J-Afzal/First-Year-Project/README.md

# Lab 1
This lab consisted of building the car from scratch, including soldering all the components needed for all PCBs, and connecting the Arduino to the four motors. Then the Arduino was first coded to move the car in a straight line for a certain distance (as shown in the gif below and to the left), then was coded to move the car in a square route of a certain size (as shown in the gif below and to the right) and whose code is shown in `Lab 1/code/Course1.ino`, and finally in a zig-zag shape whose code is shown in `Lab 1/code/Course2.ino`.

<p align="center">
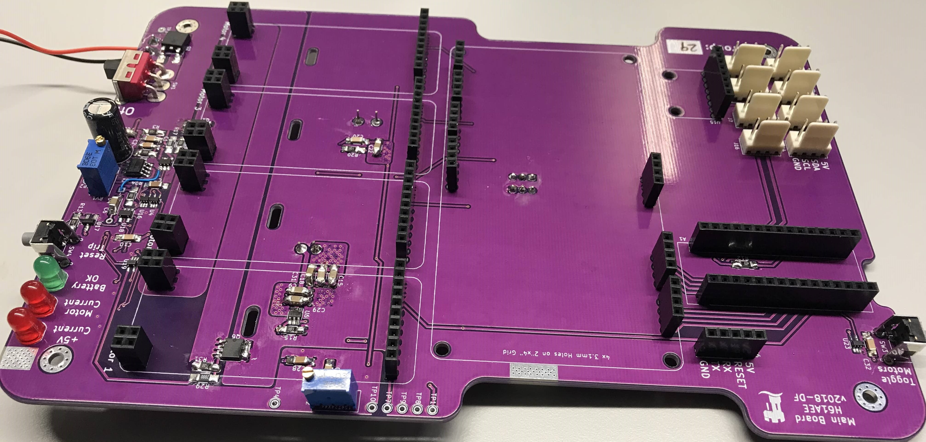
[picture p1: Lab 1/pics/car pcb top.jpg]
  
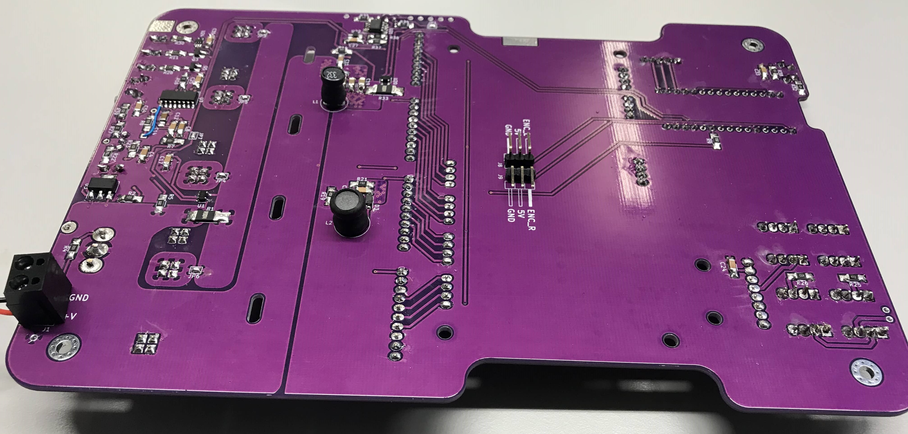
[picture p2: Lab 1/pics/car pcb bottom.jpg]
  
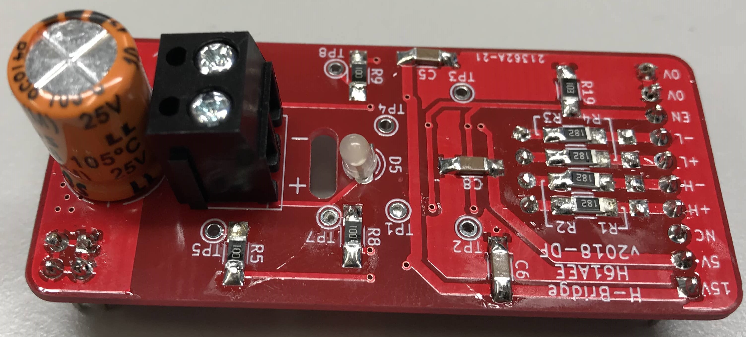
[picture p3: Lab 1/pics/h-bridge top.jpg]
  
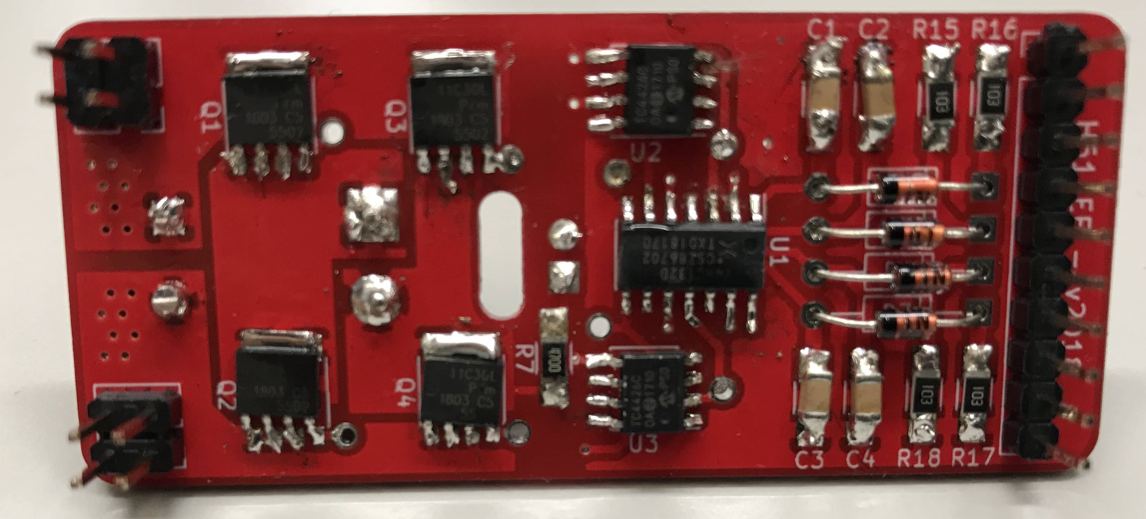
[picture p4: Lab 1/pics/h-bridge bottom.jpg]
  
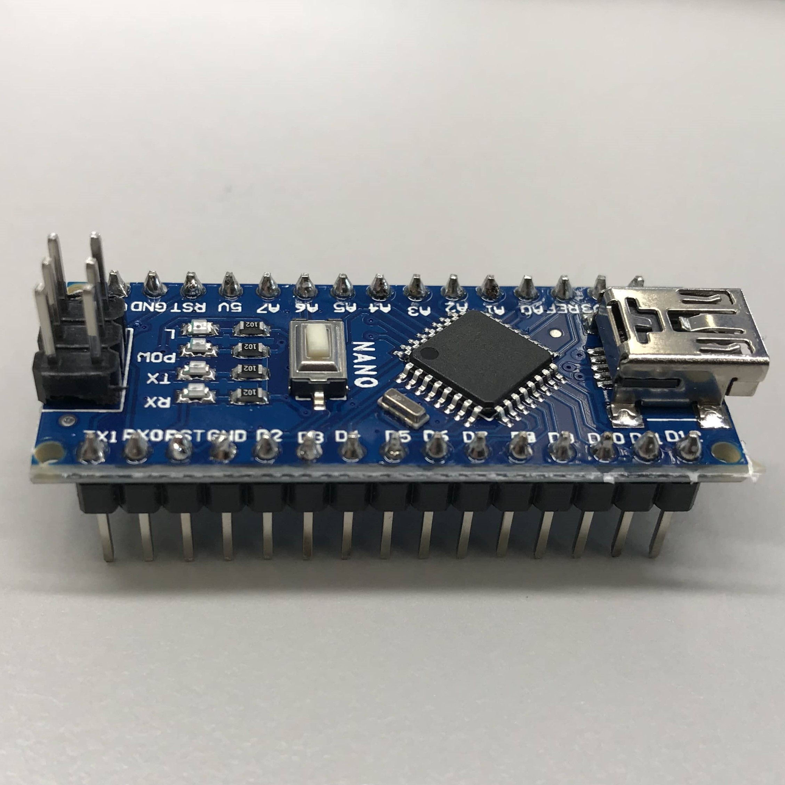
[picture p5: Lab 1/pics/arduino.jpg]
  
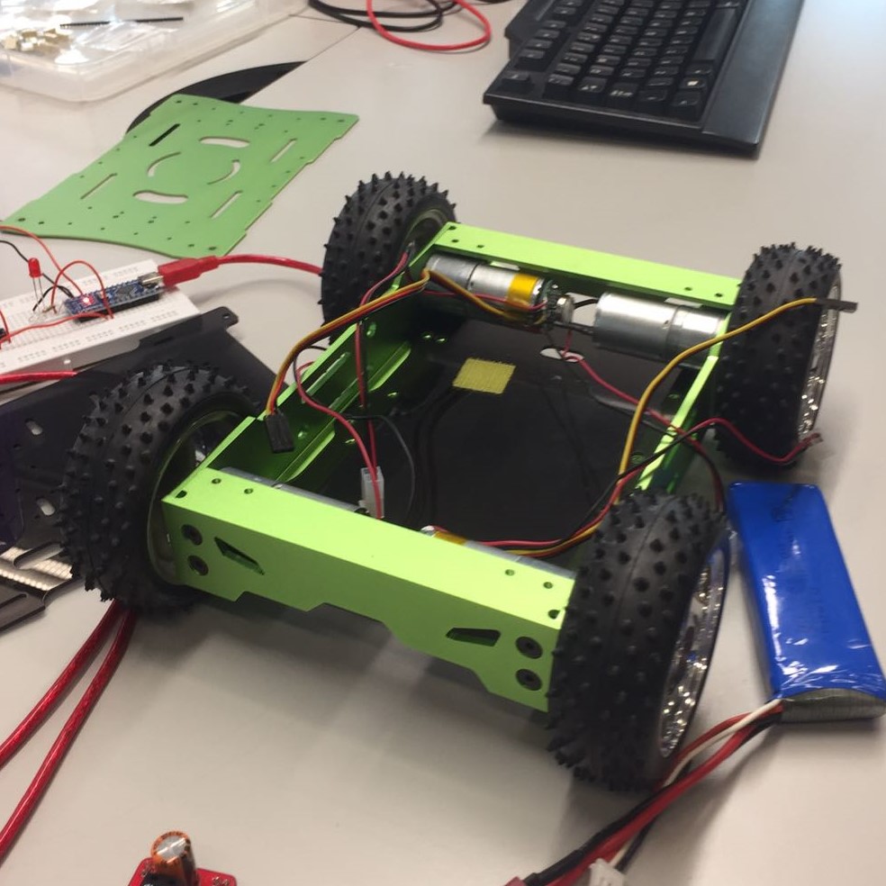
[picture p6: Lab 1/pics/car.jpg]
  
  
  
</p>

# Lab 2
This lab consisted of creating a RF remote to control the vehicle, then installing an accelerometer to the car and sending that information to a screen on the remote, and then install an array of optical sensors to the front of the car so that it could follow a black line on a white surface, as well as being able to switch. Inside the `Lab 2/code` folder, `Car_Code` represents the Arduino code that controls the motors, `Remote_Code` represents the Arduino code for the RF remote, and the `Sensor_Code` represents the Arduino code that sends the accelerometer data to the RF remote.

<p align="center">
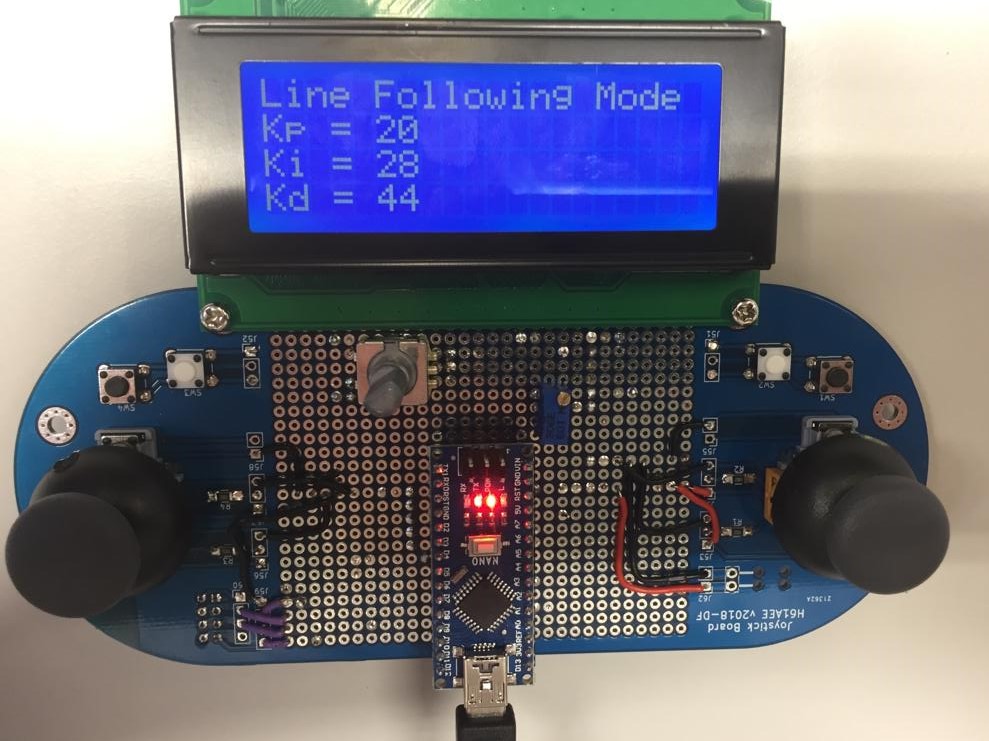
[picture p7: Lab 2/pics/line following mode.jpg]
  
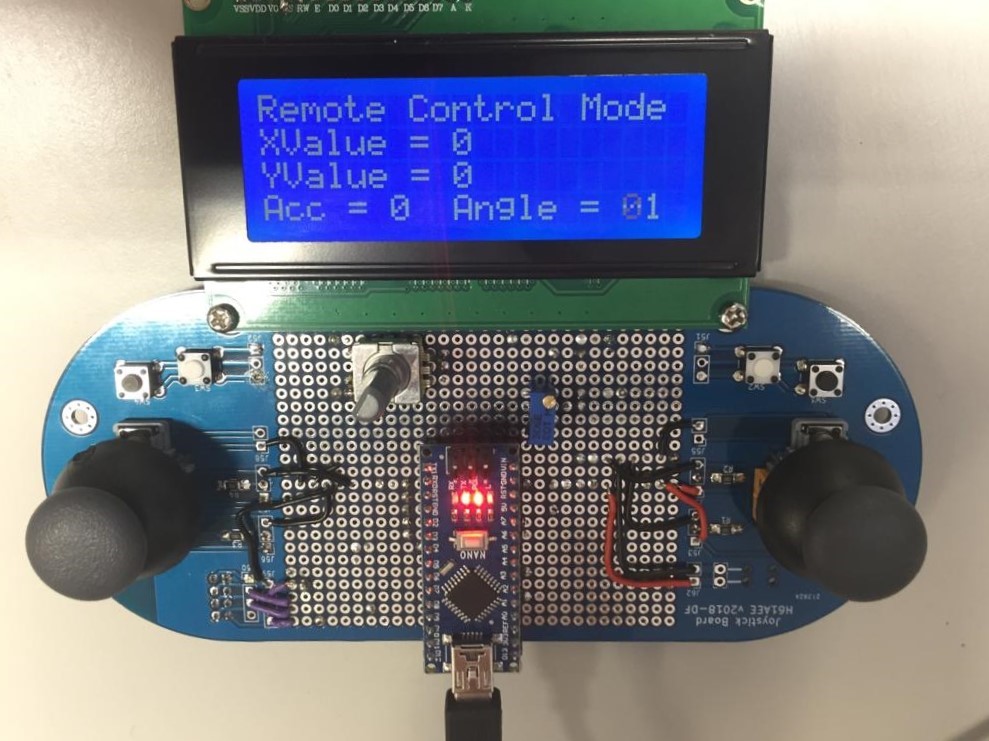
[picture p8: Lab 2/pics/remote control mode.jpg]
  
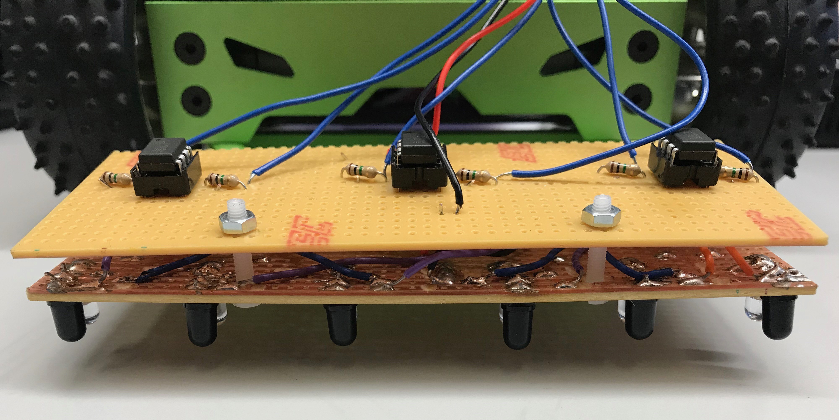
[picture p9: Lab 2/pics/optical sensor array.jpg]
  
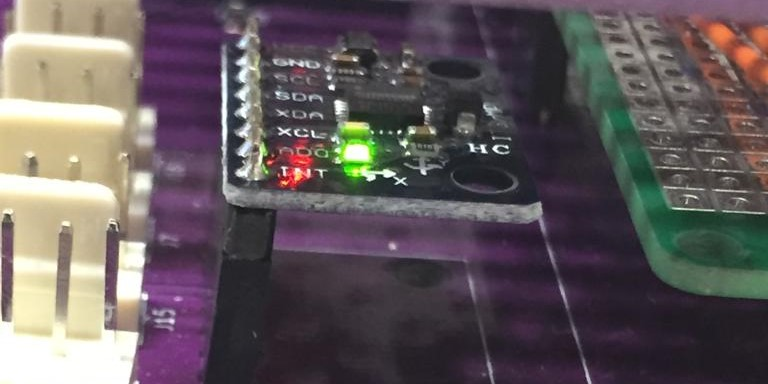
[picture p10: Lab 2/pics/accelerometer.jpg]
  
  
  
</p>

# Lab 3
This lab consisted of changing the optical sensors out for a Raspberry Pi camera on a servo, which would send the camera output to a Raspberry Pi on the car and processed by code using the computer vision library called OpenCV - this would allow the car to follow lines of different colours. This setup would also allow the camera to tilt up to detect symbols and take a certain action - however this was not implemented as symbol detection in non-lab conditions was not good due to noise.

<p align="center">
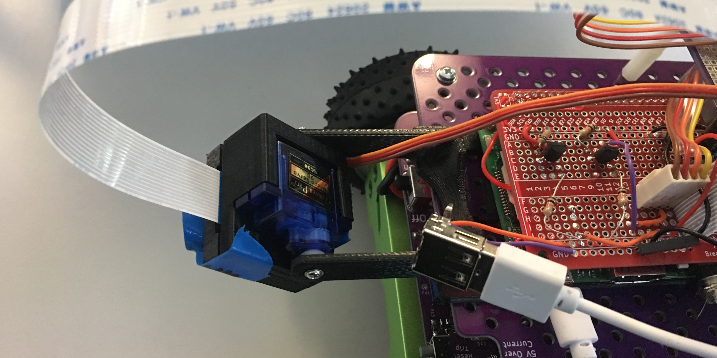
[picture p11: Lab 3/pics/camera.jpg]
  
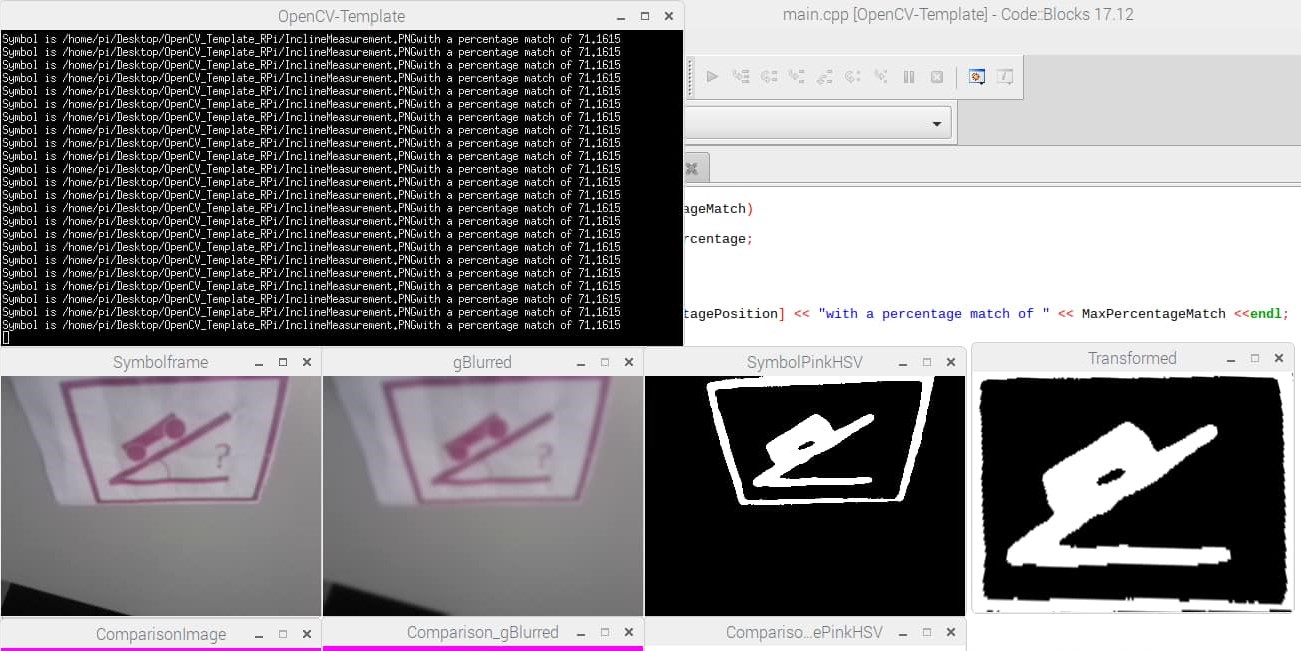
[picture p12: Lab 3/pics/symbol detection.jpg]
  
  
</p>
