J-Afzal/First-Year-Project/Lab 3/code/RaspberryPi_Code/BlueShortCut.PNG

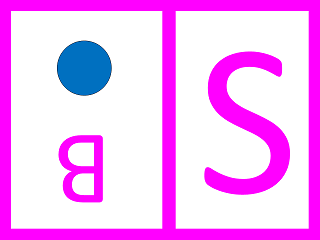
Lab 3/code/RaspberryPi_Code/BlueShortCut.PNG
