J-Afzal/First-Year-Project/Lab 3/code/RaspberryPi_Code/Football.PNG

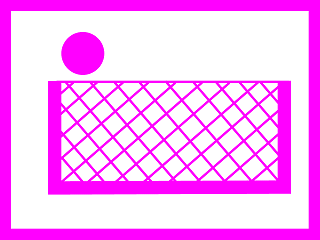
Lab 3/code/RaspberryPi_Code/Football.PNG
