J-Afzal/First-Year-Project/Lab 3/code/RaspberryPi_Code/ShapeCounter.PNG

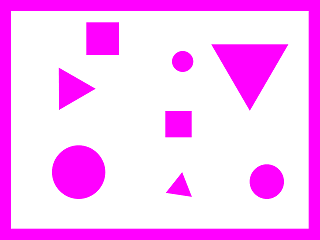
Lab 3/code/RaspberryPi_Code/ShapeCounter.PNG
