J-Afzal/First-Year-Project/Lab 3/code/RaspberryPi_Code/StopLight.PNG

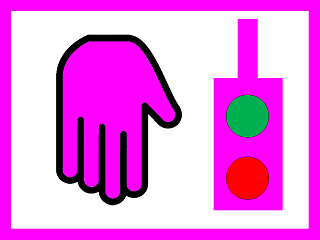
Lab 3/code/RaspberryPi_Code/StopLight.PNG
