J-Afzal/First-Year-Project/Lab 3/code/RaspberryPi_Code/DistanceMeasurement.PNG

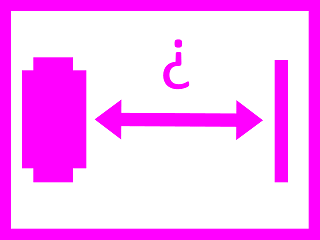
Lab 3/code/RaspberryPi_Code/DistanceMeasurement.PNG
