J-Afzal/First-Year-Project/Lab 3/code/RaspberryPi_Code/InclineMeasurement.PNG

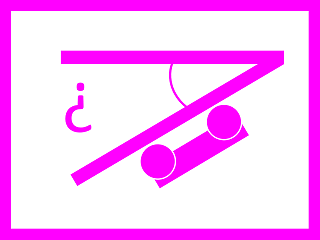
Lab 3/code/RaspberryPi_Code/InclineMeasurement.PNG
